gratak/default/obudowa-nodemcu-bme280/img/bottom.png

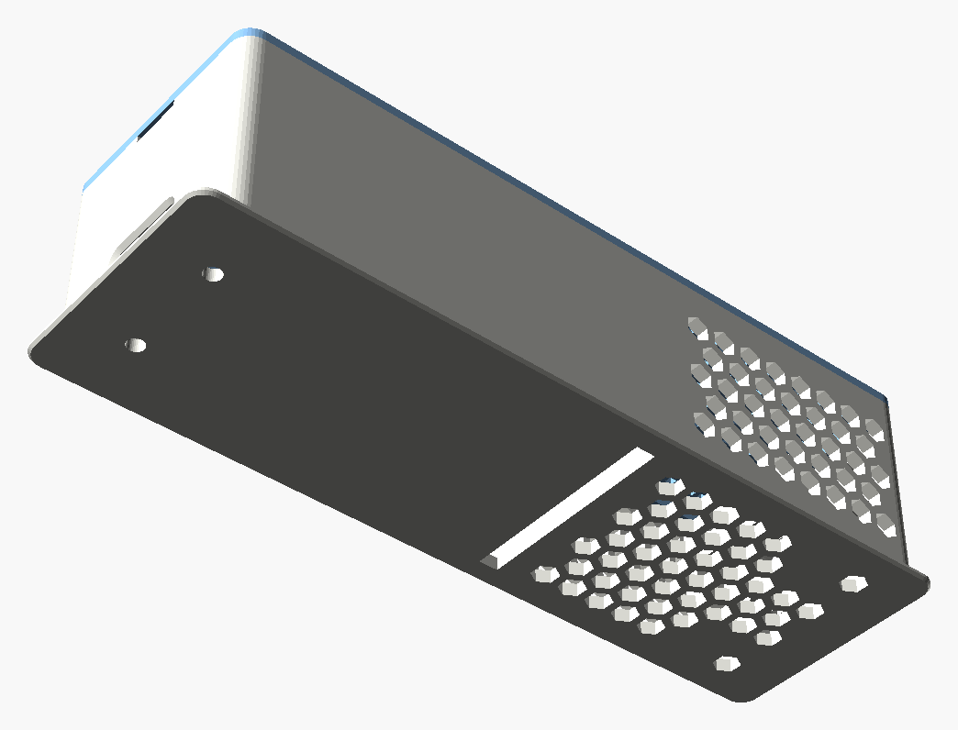
obudowa-nodemcu-bme280/img/bottom.png
