gratak/default/obudowa-nodemcu-bme280/img/cut.png

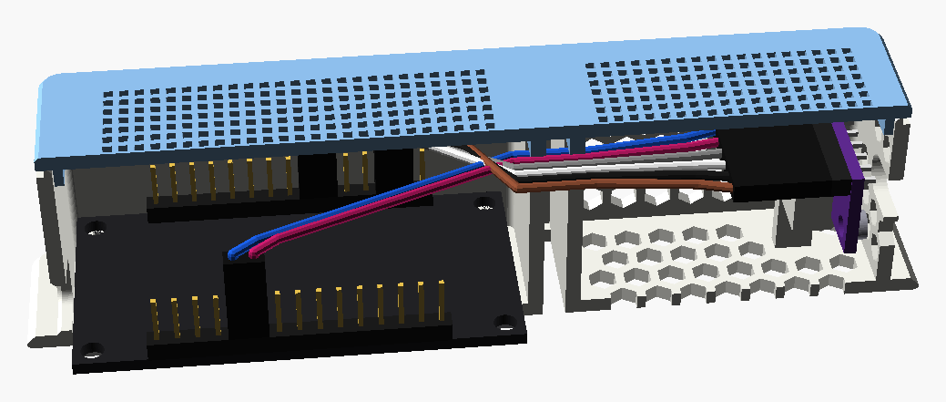
obudowa-nodemcu-bme280/img/cut.png
