gratak/default/obudowa-nodemcu-bme280/img/czujnik.png

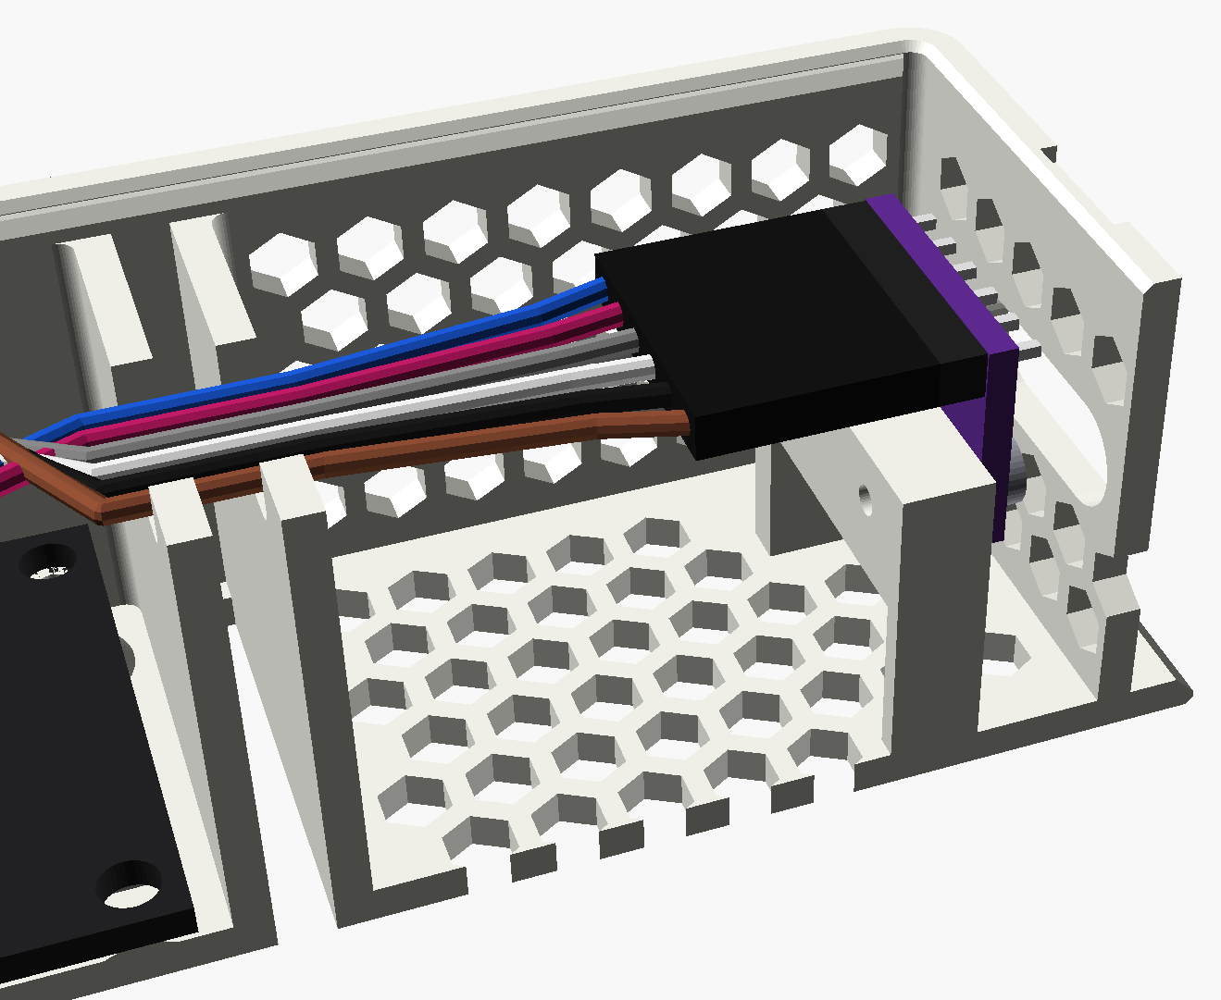
obudowa-nodemcu-bme280/img/czujnik.png
