gratak/default/obudowa-nodemcu-bme280/img/ext1.png

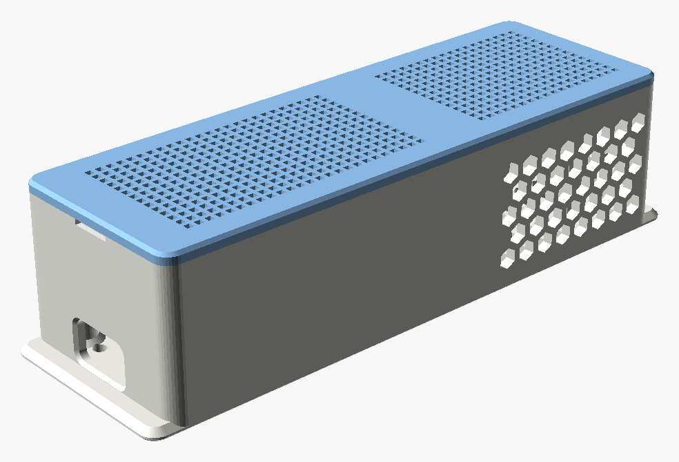
obudowa-nodemcu-bme280/img/ext1.png
