gratak/default/obudowa-nodemcu-bme280/img/ext2.png

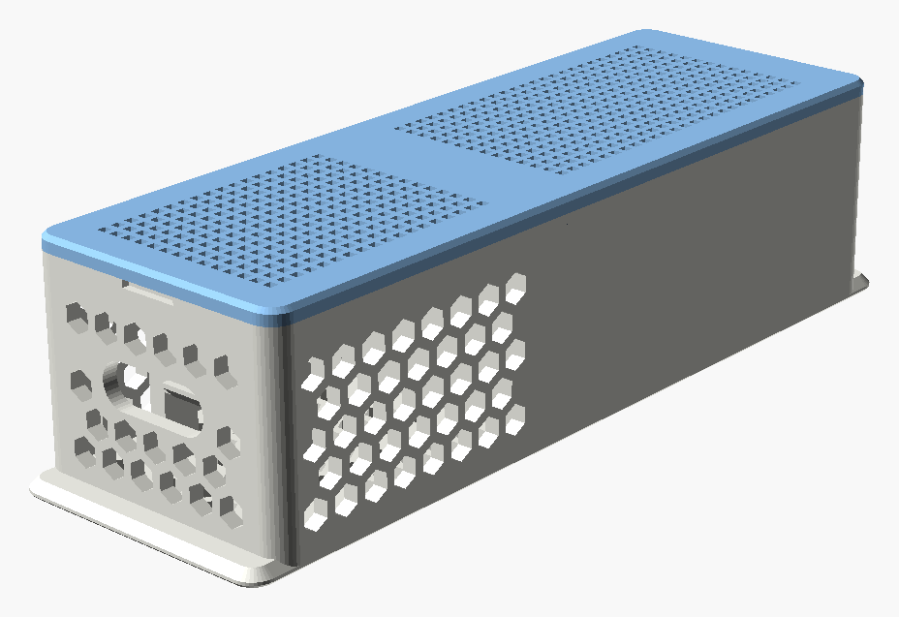
obudowa-nodemcu-bme280/img/ext2.png
