gratak/default/obudowa-nodemcu-bme280/img/kable.png

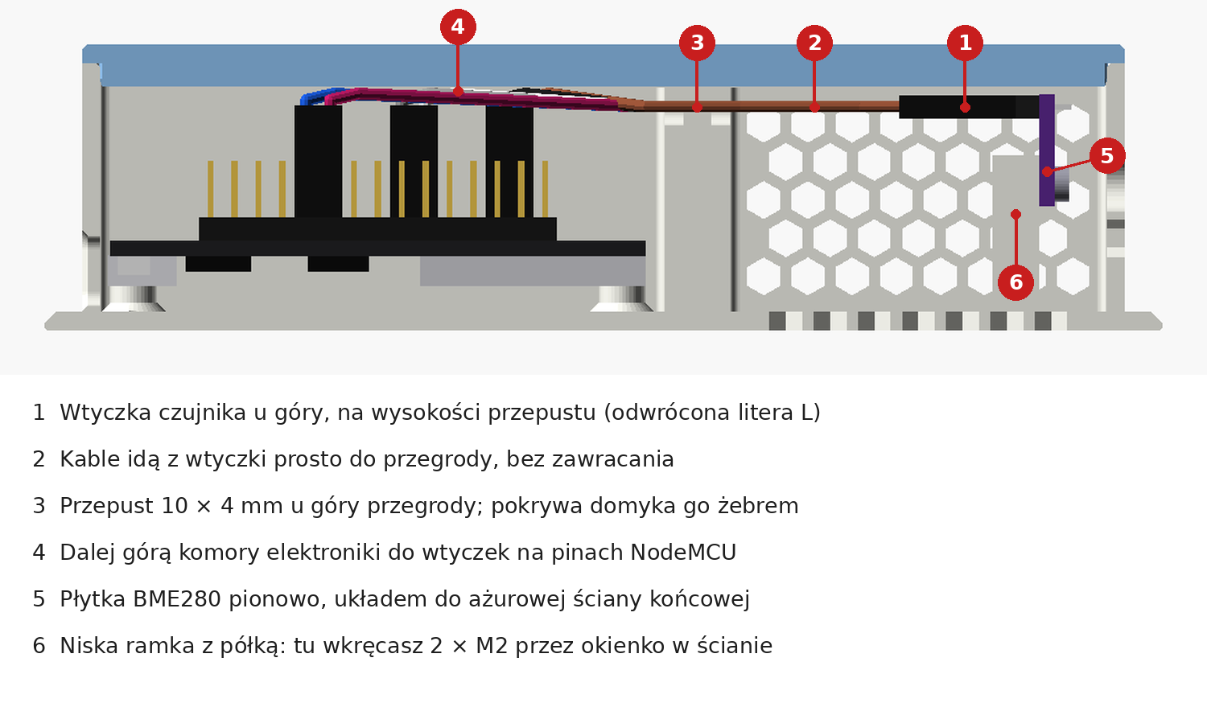
obudowa-nodemcu-bme280/img/kable.png
