gratak/default/obudowa-nodemcu-bme280/img/obudowa_obrot.gif

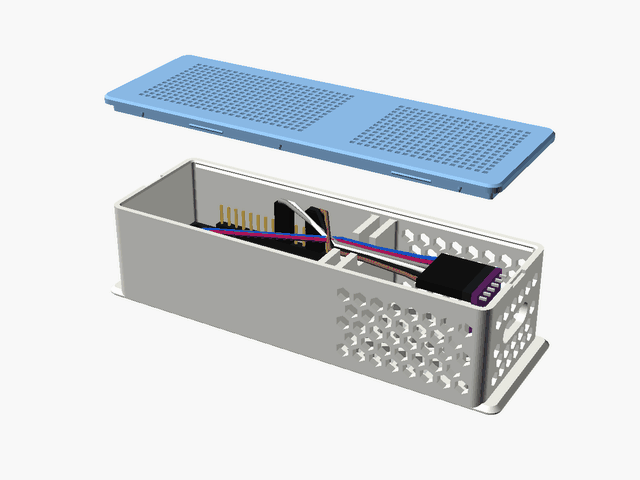
obudowa-nodemcu-bme280/img/obudowa_obrot.gif
