gratak/default/obudowa-nodemcu-bme280/img/okienko.png

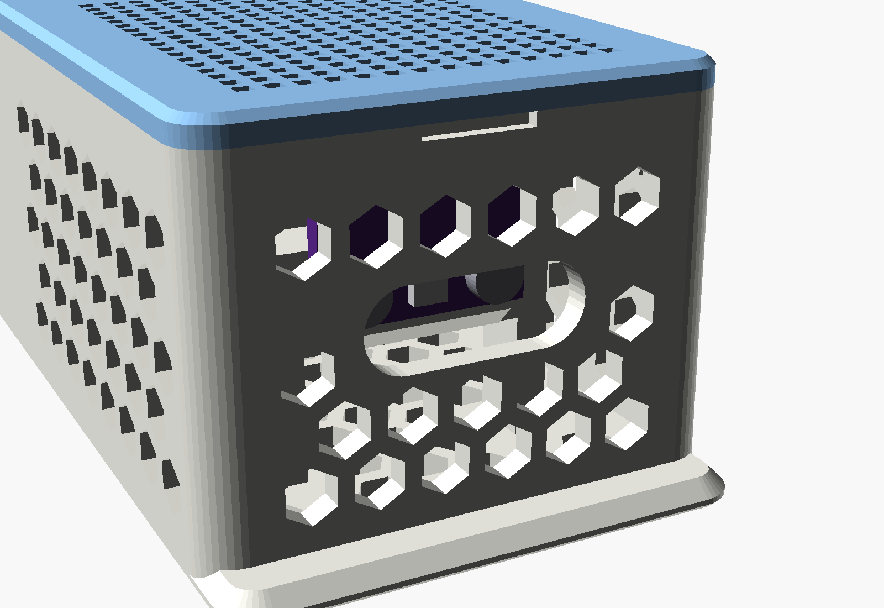
obudowa-nodemcu-bme280/img/okienko.png
