gratak/default/obudowa-nodemcu-bme280/img/open.png

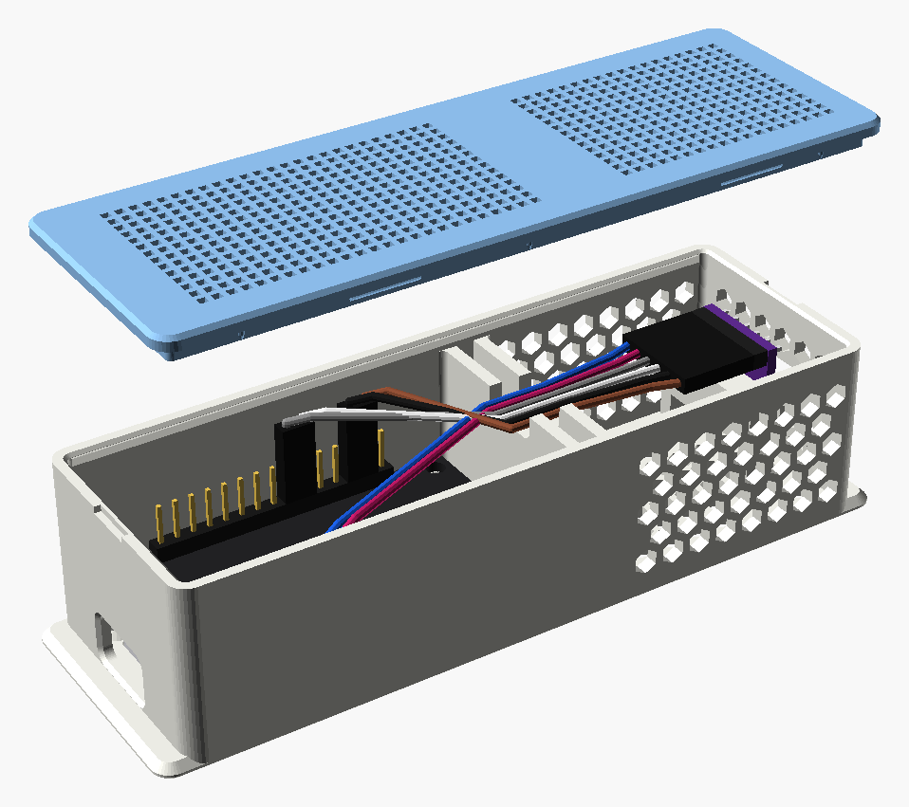
obudowa-nodemcu-bme280/img/open.png
