gratak/default/obudowa-nodemcu-bme280/img/probnik_siatki.png

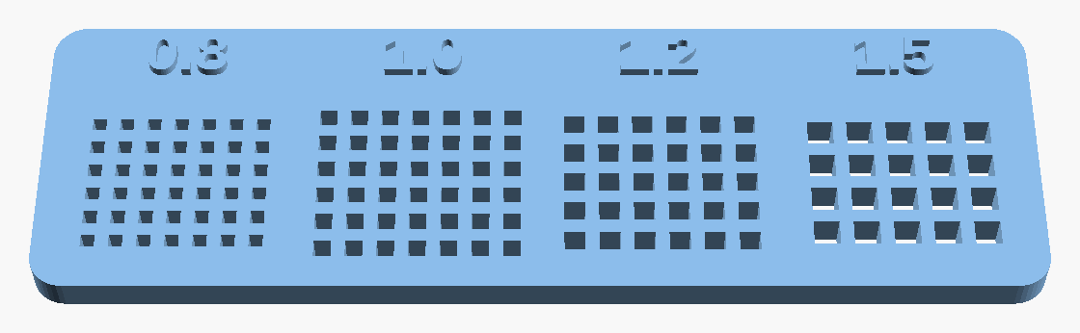
obudowa-nodemcu-bme280/img/probnik_siatki.png
