gratak/default/obudowa-nodemcu-bme280/img/przykrecanie.png

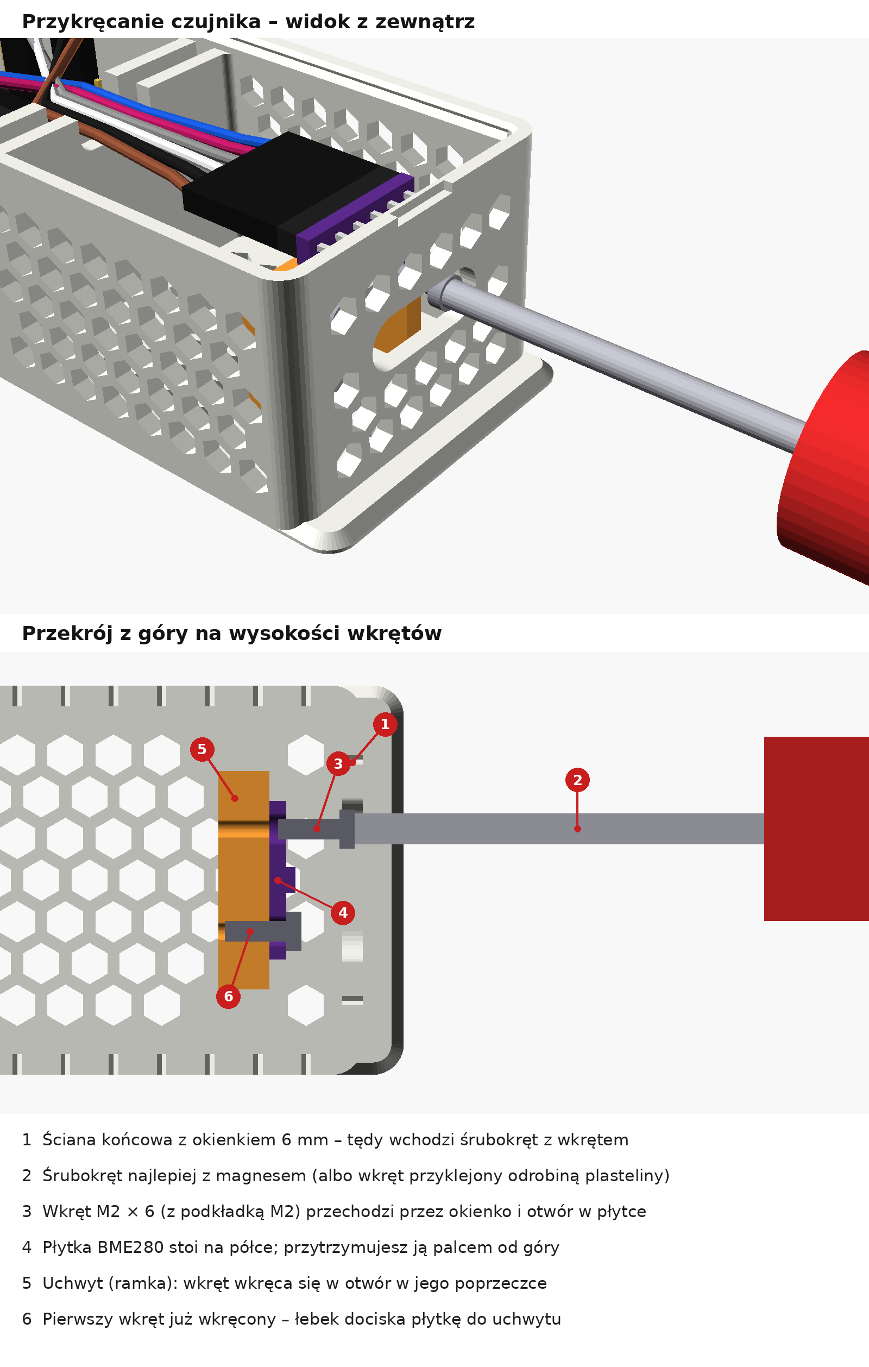
obudowa-nodemcu-bme280/img/przykrecanie.png
