gratak/default/obudowa-nodemcu-bme280/img/uchwyt_done.png

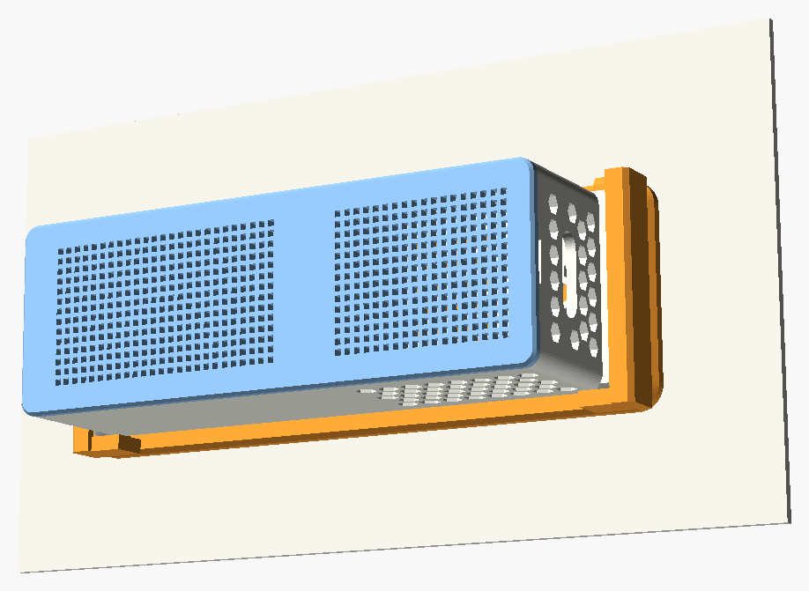
obudowa-nodemcu-bme280/img/uchwyt_done.png
