gratak/default/obudowa-nodemcu-bme280/img/uchwyt_mount.png

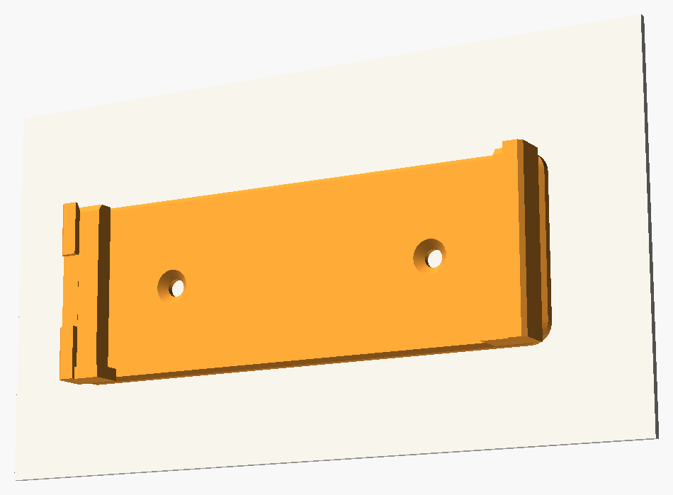
obudowa-nodemcu-bme280/img/uchwyt_mount.png
