gratak/default/obudowa-nodemcu-bme280/img/uchwyt_rail.png

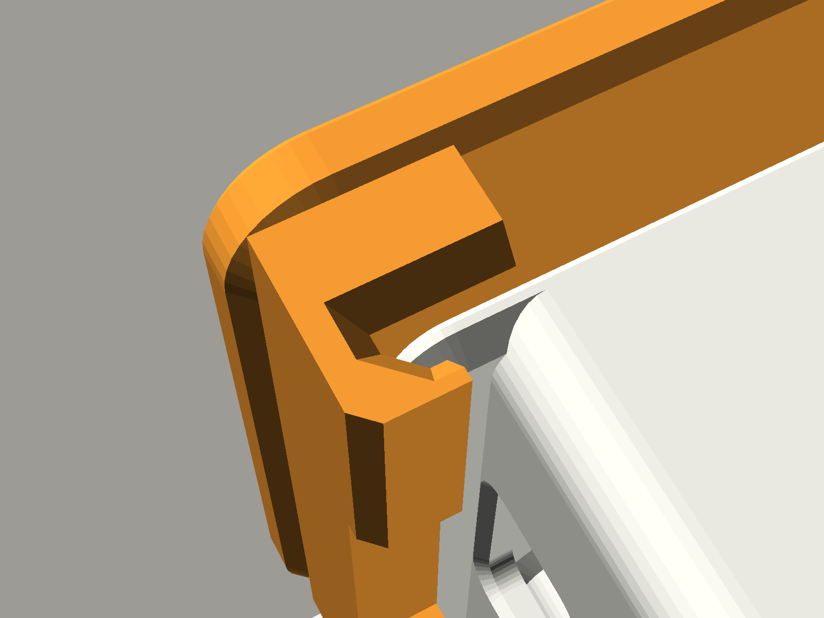
obudowa-nodemcu-bme280/img/uchwyt_rail.png
