gratak/default/obudowa-nodemcu-bme280/img/uchwyt_side.png

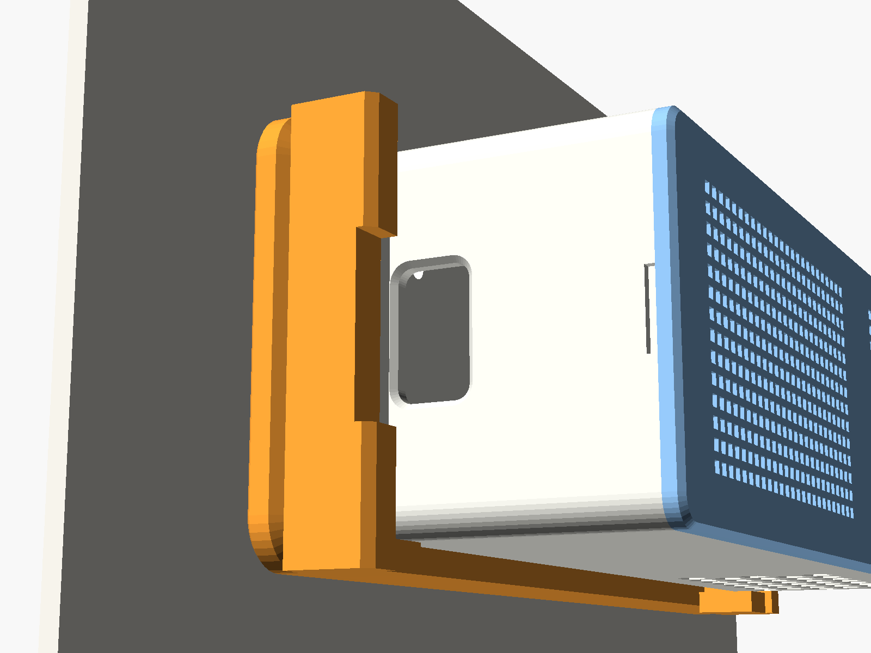
obudowa-nodemcu-bme280/img/uchwyt_side.png
