gratak/default/obudowa-nodemcu-bme280/img/uchwyt_slide.png

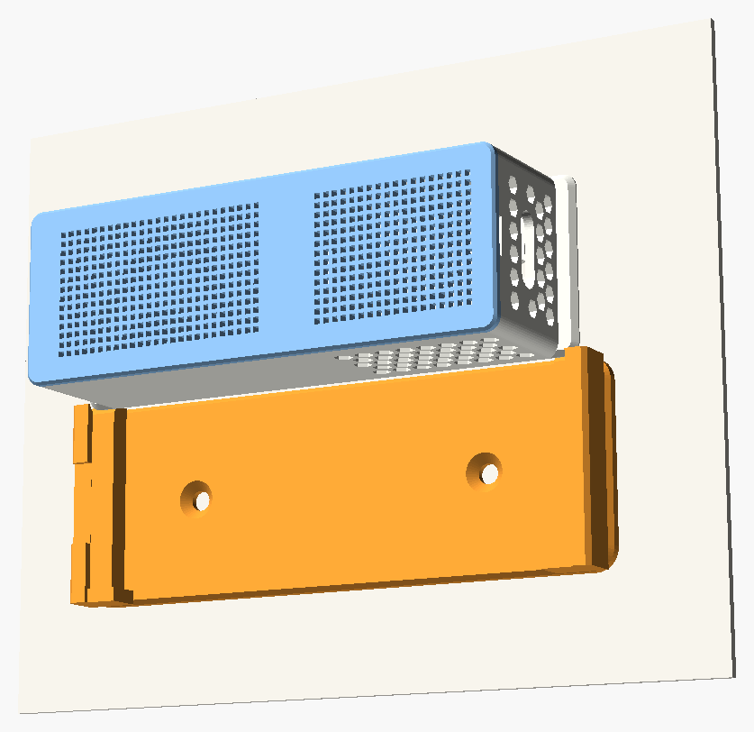
obudowa-nodemcu-bme280/img/uchwyt_slide.png
