gratak/default/obudowa-nodemcu-bme280/img/uchwyt_wsuwanie.gif

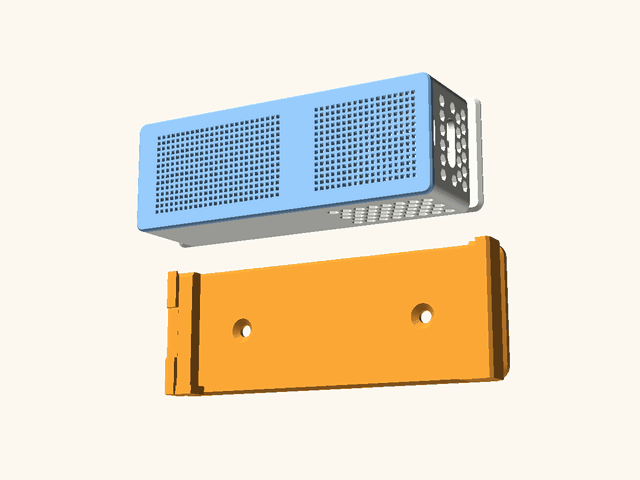
obudowa-nodemcu-bme280/img/uchwyt_wsuwanie.gif
