gratak/default/obudowa-nodemcu-bme280/stl/obudowa_pokrywa.stl

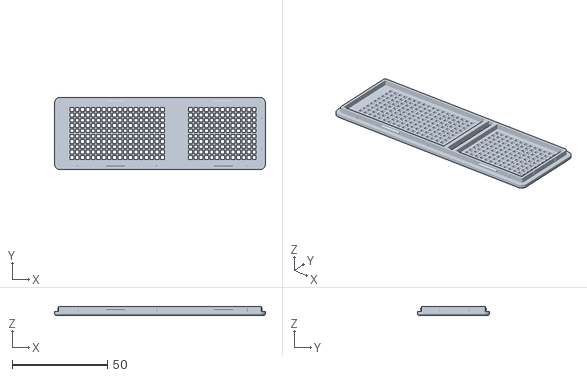
[picture p20: CAD file, 2026-11-12]
obudowa-nodemcu-bme280/stl/obudowa_pokrywa.stl
111.0 x 38.0 x 4.50
