gratak/default/obudowa-nodemcu-bme280/stl/probnik_siatki.stl

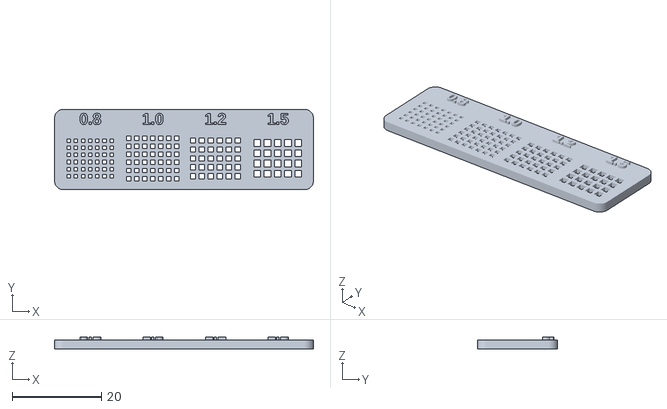
[picture p21: CAD file, 2026-11-10]
obudowa-nodemcu-bme280/stl/probnik_siatki.stl
58.0 x 18.0 x 2.59
