gratak/default/obudowa-nodemcu-bme280/stl/obudowa_podstawa.stl

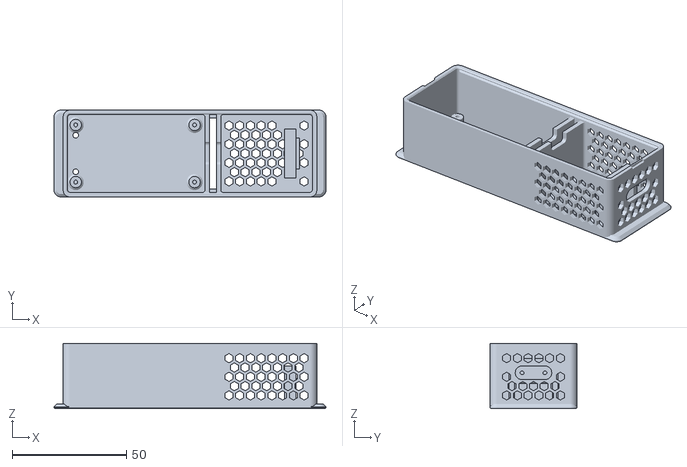
[picture p22: CAD file, 2026-11-10]
obudowa-nodemcu-bme280/stl/obudowa_podstawa.stl
119.0 x 38.0 x 28.6
