gratak/default/obudowa-nodemcu-bme280/stl/obudowa_uchwyt_scienny.stl

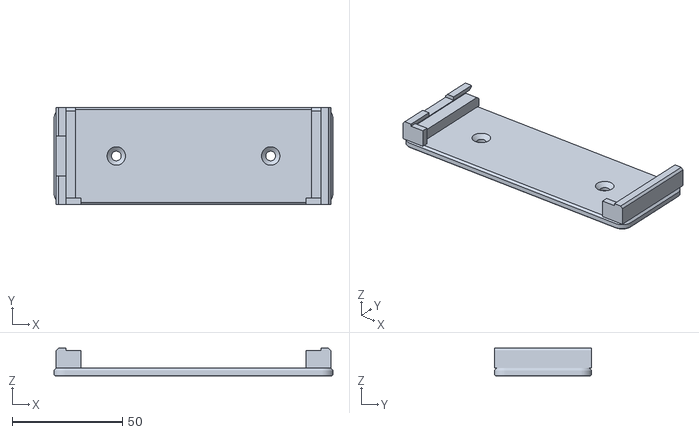
[picture p23: CAD file, 2026-11-10]
obudowa-nodemcu-bme280/stl/obudowa_uchwyt_scienny.stl
126.5 x 44.0 x 12.6
