gratak/default/obudowa-nodemcu-bme280/obudowa.scad

// =====================================================================
//  Obudowa czujnika:  NodeMCU V3 (ESP8266, CH340C, USB-C)  +  GY-BME/P280
// ---------------------------------------------------------------------
//  Plik daje DWIE CZĘŚCI DO DRUKU: podstawę i pokrywę.
//    part = "print" (domyślnie) - obie części ułożone do druku
//    part = "base" / "lid"      - jedna część; F6, potem F7 = plik STL
//    part = "assembly" / "exploded" / "section" - tylko podgląd złożenia;
//           płytki i kable są wtedy półprzezroczystym tłem i nie trafiają do STL
//
//  Dwie komory w jednym pudełku:
//    * ELEKTRONIKA – drobna siatka w pokrywie (krople wody nie przechodzą), USB-C z boku
//    * CZUJNIK     – ażur w ścianach i dnie, drobna siatka w pokrywie
//  Między nimi lita przegroda. Domyślnie PODWÓJNA: dwie pełne ścianki
//  i pionowa szczelina powietrzna, od spodu otwarta, od góry zamknięta pokrywą.
//  therm_gap = 0  ->  zwykła pojedyncza lita ścianka.
//
//  NodeMCU leży jak na zdjęciach: elementami (ESP-12, USB-C) w DÓŁ,
//  pinami i kablami do GÓRY, na 4 dystansach pod otworami 52 x 25 mm.
//
//  CZUJNIK stoi pionowo i razem z wtyczką dupont 1x6 tworzy literę L
//  (odwróconą: piny i wtyczka u góry). Układ BME280 patrzy na ażurową
//  ścianę końcową. Moduł z założoną wtyczką wkłada się od góry przed
//  niską ramkę i stawia na półce; potem 2 wkręty M2 x 6 przez okienko
//  w ścianie końcowej (śrubokręt najlepiej magnetyczny).
//  Komora ma 40 mm: moduł z pinami i zagiętymi kablami (ok. 30 mm) + luz.
//
//  KABLE CZUJNIKA: wtyczka leży na wysokości przepustu u góry przegrody
//  (10 x 4 mm, pokrywa domyka go żebrem), więc kable idą z niej prosto
//  przez przepust i dalej górą komory elektroniki do pinów NodeMCU.
//
//  DRUK bez podpór: podstawa dnem do stołu, pokrywa górą do stołu.
//  PLA/PETG, warstwa 0.2 mm, 3 obrysy, wypełnienie 20 %.
// =====================================================================

/* [Co pokazać] */
// Części do druku albo podgląd złożenia
part = "print"; // [print:Podstawa + pokrywa do druku, mesh_test:Próbnik siatki (test drukarki), print_all:Wszystkie 3 części do druku, base:Podstawa, lid:Pokrywa, mount:Uchwyt ścienny, wall:Podgląd - na ścianie, assembly:Podgląd - złożona, exploded:Podgląd - rozłożona, section:Podgląd - przekrój]
// W podglądzie (F5) pokaż kolorowe modele płytek i kabli; w renderze F6 i w STL ich nie ma
show_pcb = true;

/* [NodeMCU V3] */
pcb_l   = 57;   // długość płytki
pcb_w   = 30;   // szerokość płytki
pcb_t   = 1.6;  // grubość laminatu
hole_dx = 52;   // rozstaw otworów montażowych wzdłuż (środek-środek)
hole_dy = 25;   // rozstaw otworów w poprzek
// Wysokość dystansów = luz pod płytką (od spodu: ESP-12, USB-C, przyciski ~3.3 mm)
under_clear = 6;
// Miejsce nad laminatem: goldpiny + wtyczki dupont + zagięte kable (z zapasem)
above_clear = 19;

/* [USB-C] */
usb_w = 13;    // szerokość otworu (mieści obudowę wtyku kabla)
usb_h = 7.5;   // wysokość otworu
// Środek gniazda względem SPODU laminatu (gniazdo jest od spodu, więc ujemnie)
usb_z = -1.6;
// Przesunięcie gniazda w poprzek względem środka płytki
usb_y = 0;

/* [Mocowanie NodeMCU] */
// screw = wkręty w dystanse; peg = kołki w otworach + dociski w pokrywie
board_fix = "screw"; // [screw:Wkręty, peg:Kołki i docisk pokrywą]
standoff_d = 5;
// Otwór pod wkręt: M2 samogwintujący ~1.7 mm (M2.5 ~2.2 mm, M3 ~2.6 mm)
pilot_d = 1.7;
// Średnica kołka (otwory w płytce mają ok. 3 mm)
peg_d = 2.6;
// Otworki w dnie pod przyciskami RST i FLASH (wciskane spinaczem)
button_holes = true;

/* [Czujnik BME280] */
// Długość wewnętrzna komory czujnika (moduł z pinami i zagiętymi kablami ~30 mm + luz)
sens_len = 40;
// screw = płytka przykręcona do ramki; cradle = bez wkrętów (wtyczka w kołysce, docisk pokrywą)
sensor_mount = "screw"; // [screw:Przykręcany do ramki, cradle:Wtyczka w kołysce + docisk]
sens_w = 15.5;      // szerokość płytki czujnika (wzdłuż rzędu pinów)
sens_t = 1.6;       // grubość płytki czujnika
// Rozstaw otworów montażowych czujnika (środek-środek)
sens_hole_dx = 10;
// Odległość: oś rzędu pinów -> oś otworów montażowych (sprawdź na swojej płytce)
sens_pin_hole = 8.2;
// Odległość: oś otworów -> krawędź płytki bez pinów (tą krawędzią płytka stoi na półce)
sens_hole_e = 2.4;
// Otwór pod wkręt w ramce: M2 samogwintujący ~1.7 mm (M2.5 ~2.2 mm, M3 ~2.6 mm)
sens_pilot_d = 1.7;
// Odstęp strony z układem BME280 od ściany końcowej (łebki wkrętów + luz przy wkładaniu)
sens_gap = 5.5;
// Wysokość okienka na śrubokręt w ścianie końcowej (przechodzi przez nie łebek wkrętu)
win_h = 6;
plug_w = 15.24;     // szerokość wtyczki dupont 1x6 (6 x 2.54)
plug_h = 2.54;      // grubość wtyczki
// --- tylko dla sensor_mount = "cradle" ---
plug_ped = 2;       // wtyczka leży na podeście tej wysokości (czujnik nad dnem)
cradle_len = 10;    // długość kołyski
// Słupek w pokrywie dociskający wtyczkę czujnika
plug_holddown = true;

/* [Ściany i przegroda] */
wall = 2;
floor_t = 2;
lid_t = 2;
corner_r = 3;
gap_usb = 1;       // luz: krawędź płytki - ściana z USB
gap_div = 2;       // luz: krawędź płytki - przegroda
gap_side = 2;      // luz boczny (z każdej strony)
div_t = 2;         // grubość ścianki przegrody
// Szczelina powietrzna między ściankami przegrody (0 = jedna lita ścianka)
therm_gap = 3;
// Otwór nad tą szczeliną w pokrywie (wypada nad przepustem kabli; zamknięty chroni przed kroplami)
gap_lid_open = false;
wire_w = 10;       // przepust na kable w przegrodzie - szerokość
wire_d = 4;        // przepust - głębokość od góry przegrody

/* [Pokrywa i zatrzaski] */
lip_h = 2.5;       // wysokość kołnierza pokrywy
lip_t = 1.2;       // grubość kołnierza
fit = 0.15;        // luz pasowania (zwiększ, jeśli pokrywa wchodzi za ciasno)
snap = 0.6;        // wysokość ząbków zatrzasku (0 = tylko na wcisk)
// Żeberka dociskowe na kołnierzu pokrywy: przy zakładaniu lekko się wgniatają
// i kasują luz (0 = bez; za ciasno -> 0.2, nadal luźno -> 0.4)
crush = 0.3;
snap_len = 10;     // długość ząbka

/* [Wentylacja] */
slot_w = 2;          // szerokość szczelin
slot_pitch = 4.5;    // rozstaw szczelin
floor_slots = false; // szczeliny w dnie pod płytką
// Pionowe szczeliny w ścianach bocznych komory elektroniki
el_side_slots = false;
// Pokrywa nad elektroniką: drobna siatka (krople wody nie przechodzą) albo dawne szczeliny
lid_vent = "mesh"; // [mesh:Drobna siatka, slots:Szczeliny]
// Oczko siatki (kwadrat). Dysza 0.4: pewnie 1.0-1.2 mm, mniejsze potrafią zarosnąć
mesh_hole = 2;
// Mostek między oczkami: 0.8 mm = 2 ścieżki dyszy 0.4
mesh_web = 0.8;
// Ażur w ścianach i dnie komory czujnika (mesh = drobna siatka jak w pokrywie)
hole_shape = "hex"; // [hex:Plaster miodu, circle:Okrągłe oczka, mesh:Drobna siatka]
// Pokrywa nad czujnikiem: drobna siatka (krople wody nie przechodzą) albo ażur jak w ścianach
lid_sensor_mesh = true;
hole_size = 3.5;     // wielkość oczka ażuru (tylko hex / circle)
hole_web = 1.2;      // mostek między oczkami (tylko hex / circle)

/* [Uchwyt ścienny] */
// Kołnierze na końcach podstawy, którymi obudowa wsuwa się w uchwyt ścienny
wall_mount = true;
// Po której stronie jest USB-C, patrząc na zamontowaną obudowę
usb_side = "left"; // [left:Lewa, right:Prawa]
fl_w = 4;            // wysunięcie kołnierza poza ścianę czołową
fl_t = 2;            // grubość kołnierza
fl_base = 0.8;       // pionowa krawędź kołnierza (wyżej skos 45° = jaskółczy ogon)
mnt_gap = 5;         // szczelina powietrzna między płytą uchwytu a dnem obudowy
mnt_plate = 3.5;     // grubość płyty uchwytu
mnt_clear = 0.25;    // luz w prowadnicach (zwiększ, jeśli obudowa wchodzi za ciasno)
mnt_wall = 2.5;      // grubość zewnętrznej ścianki prowadnicy
mnt_lip = 1.8;       // grubość wargi nad kołnierzem
mnt_margin = 3;      // płyta wystaje tyle nad i pod obudowę
screw_wall_d = 4;    // wkręty do ściany (3.5-4 mm, z kołkiem)
screw_wall_head = 8; // średnica łba wkrętu stożkowego
screw_wall_dx = 70;  // rozstaw otworów w płycie

/* [Hidden] */
$fn = 40;
eps = 0.01;

// ---------------------------------------------------------------------
//  Wymiary wynikowe  (oś X: od ściany z USB, Y: od przodu, Z: od dna)
// ---------------------------------------------------------------------
in_w    = pcb_w + 2*gap_side;                  // szerokość wnętrza
el_len  = gap_usb + pcb_l + gap_div;           // długość komory elektroniki
in_h    = under_clear + pcb_t + above_clear;   // wysokość wnętrza
div_tot = therm_gap > 0 ? 2*div_t + therm_gap : div_t;

L  = 2*wall + el_len + div_tot + sens_len;     // długość zewnętrzna
W  = in_w + 2*wall;                            // szerokość zewnętrzna
Hb = floor_t + in_h;                           // wysokość podstawy
H  = Hb + lid_t;                               // wysokość całkowita

x_d1 = wall + el_len;       // przegroda od strony elektroniki
x_s0 = x_d1 + div_tot;      // początek komory czujnika
x_s1 = x_s0 + sens_len;     // koniec komory czujnika
yc   = W/2;

r_in    = max(corner_r - wall, 0.4);
pcb_x0  = wall + gap_usb;
pcb_y0  = wall + gap_side;
pcb_z0  = floor_t + under_clear;   // spód laminatu
div_top = Hb - lip_h - 0.2;        // góra przegrody w podstawie (wyżej są żebra pokrywy)
lip_in  = wall + fit + lip_t;      // wewnętrzna krawędź kołnierza
zg      = Hb - lip_h/2;            // wysokość zatrzasków

holes = [for (i = [0, 1], j = [0, 1])
         [pcb_x0 + (pcb_l - hole_dx)/2 + i*hole_dx,
          pcb_y0 + (pcb_w - hole_dy)/2 + j*hole_dy]];

// --- czujnik (układ L: płytka pionowo, wtyczka poziomo) ---
screw_s  = sensor_mount == "screw";
hl       = 12.5;                              // długość wtyczki dupont (model poglądowy)
sens_d   = 1.3 + sens_pin_hole + sens_hole_e; // wysokość płytki czujnika (model)
s_back   = x_s1 - sens_gap - sens_t;          // tył płytki (strona z wtyczką)
s_face   = s_back + sens_t;                   // strona z układem BME280
plug_end = s_back - 2.5 - hl;                 // koniec wtyczki, z którego wychodzą kable
// screw: piny i wtyczka u góry, na wysokości przepustu w przegrodzie
// cradle: piny i wtyczka na dole, wtyczka w kołysce
pin_z    = screw_s ? div_top - wire_d/2 : floor_t + plug_ped + plug_h/2;
s_hz     = screw_s ? pin_z - sens_pin_hole : pin_z + sens_pin_hole;   // oś otworów
s_hys    = [yc - sens_hole_dx/2, yc + sens_hole_dx/2];
pcb_lo   = screw_s ? s_hz - sens_hole_e : pin_z - 1.3;               // dolna krawędź płytki

// ramka za płytką (tylko screw): nóżki + poprzeczka z otworami + półka pod płytkę
fr_t   = 5;                 // grubość (X)
fr_leg = 2.4;               // grubość nóżki (Y)
fr_in  = sens_w/2 + 0.5;    // wewnętrzna krawędź nóżki od osi
fr_z0  = s_hz - 4.5;        // poprzeczka: dół
fr_z1  = s_hz + 3;          // poprzeczka: góra (wtyczka przechodzi nad nią)

// kołyska (tylko cradle)
holddown  = !screw_s && plug_holddown;
rail_t    = 1.2;
cradle_iw = plug_w + 0.4;
plug_z    = floor_t + plug_ped;               // spód wtyczki
cradle_x0 = plug_end + 0.5;
post_x    = cradle_x0 + cradle_len/2;

echo(str("Obudowa zewn.: ", L, " x ", W, " x ", H, " mm  (dł. x szer. x wys.)"));
if (screw_s)
    echo(str("Czujnik: otwory montażowe ", s_hz, " mm nad spodem, rozstaw ", sens_hole_dx,
             " mm; od końca wtyczki do przegrody ", plug_end - x_s0, " mm"));

// ---------------------------------------------------------------------
//  Pomocnicze kształty 2D
// ---------------------------------------------------------------------
module rrect(s, r) {
    if (r > 0) translate([r, r]) offset(r = r) square([s[0] - 2*r, s[1] - 2*r]);
    else square(s);
}

// szczelina wzdłuż +Y (0..len), wyśrodkowana w X
module stadium(len, w) {
    hull() {
        translate([0, w/2]) circle(d = w);
        translate([0, len - w/2]) circle(d = w);
    }
}

// rząd szczelin pionowych (wzdłuż Y) w prostokącie w x h
// drobna siatka: kwadratowe oczka mesh_hole co (mesh_hole + mesh_web), wyśrodkowana w w x h
module mesh_grid(w, h, hole = mesh_hole, web = mesh_web) {
    p  = hole + web;
    nx = floor((w - hole) / p);
    ny = floor((h - hole) / p);
    ox = (w - nx*p - hole) / 2;
    oy = (h - ny*p - hole) / 2;
    if (nx >= 0 && ny >= 0)
        for (i = [0:nx], j = [0:ny]) translate([ox + i*p, oy + j*p]) square(hole);
}

// próbnik: 4 pola siatki (oczka 0.8 / 1.0 / 1.2 / 1.5 mm) w płytce o grubości pokrywy
module mesh_test() {
    sizes = [0.8, 1.0, 1.2, 1.5];
    difference() {
        linear_extrude(lid_t) rrect([4*14 + 2, 18], 2);
        for (k = [0:3]) translate([2 + k*14, 2, -1]) linear_extrude(lid_t + 2)
            mesh_grid(12, 10, sizes[k], mesh_web);
    }
    // opisy na górze płytki
    for (k = [0:3]) translate([2 + k*14 + 6, 14.6, lid_t - eps]) linear_extrude(0.6)
        text(["0.8", "1.0", "1.2", "1.5"][k], size = 2.6, halign = "center", font = "Liberation Sans:style=Bold");
}

module slot_row(w, h, m = 0) {
    n  = floor((w - 2*m - slot_w) / slot_pitch);
    ox = (w - n*slot_pitch) / 2;
    if (n >= 0) for (i = [0:n]) translate([ox + i*slot_pitch, m]) stadium(h - 2*m, slot_w);
}

// pojedyncze oczko ażuru; heksagon "ostrzem do góry" drukuje się bez podpór
module cell() {
    if (hole_shape == "hex") rotate(30) circle(r = hole_size/sqrt(3), $fn = 6);
    else circle(d = hole_size, $fn = 24);
}

function hit(cx, cy, rx, ry, ex) =
    len([for (e = ex) if (cx + rx > e[0] && cx - rx < e[2] &&
                          cy + ry > e[1] && cy - ry < e[3]) 1]) > 0;
function hitc(cx, cy, rr, ec) =
    len([for (c = ec) if (norm([cx - c[0], cy - c[1]]) < c[2] + rr) 1]) > 0;
// odległość punktu p od odcinka a-b
function seg_dist(p, a, b) =
    let(ab = b - a, t = max(0, min(1, ((p - a)*ab) / (ab*ab)))) norm(p - (a + t*ab));
function hits(cx, cy, rr, es) =
    len([for (s = es) if (seg_dist([cx, cy], [s[0], s[1]], [s[2], s[3]]) < s[4] + rr) 1]) > 0;

// siatka oczek (plaster miodu) mieszcząca się w prostokącie w x h z marginesem m;
// bez otworów w miejscach: ex = prostokąty [x0,y0,x1,y1], ec = koła [x,y,r],
// es = podłużne otwory [x0,y0,x1,y1,r] (odcinek + promień)
module cell_grid(w, h, m = 1.2, ex = [], ec = [], es = []) {
    if (hole_shape == "mesh") mesh_cells(w, h, m, ex, ec, es);
    else hex_cells(w, h, m, ex, ec, es);
}

// drobna siatka z kwadratowych oczek (mesh_hole co mesh_hole + mesh_web) z tymi samymi wykluczeniami
module mesh_cells(w, h, m, ex, ec, es) {
    f  = mesh_hole;
    p  = mesh_hole + mesh_web;
    rr = f/sqrt(2);                 // połowa przekątnej oczka
    nx = floor((w - 2*m - f) / p);
    ny = floor((h - 2*m - f) / p);
    ox = (w - nx*p) / 2;
    oy = (h - ny*p) / 2;
    if (nx >= 0 && ny >= 0)
        for (j = [0:ny], i = [0:nx]) {
            cx = ox + i*p;
            cy = oy + j*p;
            if (!hit(cx, cy, f/2 + mesh_web/2, f/2 + mesh_web/2, ex) &&
                !hitc(cx, cy, rr, ec) && !hits(cx, cy, rr, es))
                translate([cx - f/2, cy - f/2]) square(f);
        }
}

module hex_cells(w, h, m, ex, ec, es) {
    f  = hole_size;
    hh = hole_shape == "hex" ? 2*hole_size/sqrt(3) : hole_size;
    px = f + hole_web;
    py = px*sqrt(3)/2;
    nx = floor((w - 2*m - f) / px);
    ny = floor((h - 2*m - hh) / py);
    ox = (w - nx*px) / 2;
    oy = (h - ny*py) / 2;
    if (nx >= 0 && ny >= 0)
        for (j = [0:ny], i = [0:nx]) {
            cx = ox + i*px + (j % 2)*px/2;
            cy = oy + j*py;
            if (cx + f/2 <= w - m + eps &&
                !hit(cx, cy, f/2 + hole_web/2, hh/2 + hole_web/2, ex) &&
                !hitc(cx, cy, hh/2, ec) && !hits(cx, cy, hh/2, es))
                translate([cx, cy]) cell();
        }
}

// ---------------------------------------------------------------------
//  Przenoszenie wzorów 2D na ściany (narzędzia do wycinania)
// ---------------------------------------------------------------------
// ściana przednia i tylna: 2D (u,v) -> (x0+u, z0+v)
module through_long_walls(x0, z0) {
    for (y = [wall + 1, W + 1])
        translate([x0, y, z0]) rotate([90, 0, 0]) linear_extrude(wall + 2) children();
}
// ściana czołowa (x = 0 lub x = L): 2D (u,v) -> (y0+u, z0+v)
module through_end_wall(xw, y0, z0) {
    translate([xw - 1, y0, z0]) rotate([90, 0, 90]) linear_extrude(wall + 2) children();
}

// trójkątny ząbek wzdłuż X (0..len), wystaje w -Y, symetryczny względem z = 0
module ridge(len, h) {
    rotate([0, 90, 0]) linear_extrude(len) polygon([[h, 0], [-h, 0], [0, -h]]);
}
// to samo po stronie tylnej (lustro względem środka szerokości)
module both_sides() {
    children();
    translate([0, W, 0]) mirror([0, 1, 0]) children();
}

// okienko w ścianie końcowej na śrubokręt (przed układem BME280)
module sensor_window_2d() {
    hull() for (y = s_hys) translate([y, s_hz]) circle(d = win_h);
}

// ---------------------------------------------------------------------
//  PODSTAWA
// ---------------------------------------------------------------------
module base() {
    difference() {
        union() {
            difference() {
                // bryła z fazką 0.4 mm przy stole (kompensacja "stopy słonia")
                union() {
                    hull() {
                        translate([0.4, 0.4, 0]) linear_extrude(eps) rrect([L - 0.8, W - 0.8], corner_r - 0.4);
                        translate([0, 0, 0.4]) linear_extrude(Hb - 0.4) rrect([L, W], corner_r);
                    }
                    if (wall_mount) flange();
                }
                // komora elektroniki
                translate([wall, wall, floor_t]) linear_extrude(Hb) rrect([el_len, in_w], r_in);
                // komora czujnika
                translate([x_s0, wall, floor_t]) linear_extrude(Hb) rrect([sens_len, in_w], r_in);
                // szczelina termiczna między ściankami przegrody
                if (therm_gap > 0)
                    translate([x_d1 + div_t, wall, floor_t]) cube([therm_gap, in_w, Hb]);
                // nad przegrodą wspólna wnęka na kołnierz pokrywy
                translate([wall, wall, div_top]) linear_extrude(Hb) rrect([L - 2*wall, in_w], r_in);
            }
            // dystanse pod NodeMCU
            for (h = holes) translate([h[0], h[1], floor_t - eps]) {
                cylinder(d1 = standoff_d + 2, d2 = standoff_d, h = 1);
                cylinder(d = standoff_d, h = under_clear + eps);
                if (board_fix == "peg") translate([0, 0, under_clear]) {
                    cylinder(d = peg_d, h = pcb_t + 0.7);
                    translate([0, 0, pcb_t + 0.7 - eps])
                        cylinder(d1 = peg_d, d2 = peg_d - 0.8, h = 0.5);
                }
            }
            if (screw_s) {
                // niska ramka za płytką czujnika: dwie nóżki + poprzeczka z otworami;
                // wtyczka czujnika jest wyżej, więc moduł wkłada się od góry
                for (s = [-1, 1])
                    translate([s_back - fr_t, s > 0 ? yc + fr_in : yc - fr_in - fr_leg, floor_t - eps])
                        cube([fr_t, fr_leg, fr_z1 - floor_t + eps]);
                translate([s_back - fr_t, yc - fr_in - fr_leg, fr_z0])
                    cube([fr_t, 2*(fr_in + fr_leg), fr_z1 - fr_z0]);
                // półka pod dolną krawędzią płytki (ustawia wysokość przy wkręcaniu), spód 45°
                translate([s_back - eps, yc + sens_w/2 - 1, pcb_lo]) rotate([90, 0, 0])
                    linear_extrude(sens_w - 2)
                        polygon([[0, 0], [sens_t, 0], [sens_t, -0.6], [0, -0.6 - sens_t]]);
            } else {
                // kołyska wtyczki czujnika: podest + dwie prowadnice
                translate([cradle_x0, yc - cradle_iw/2 - rail_t, 0])
                    cube([cradle_len, cradle_iw + 2*rail_t, plug_z]);
                for (s = [-1, 1])
                    translate([cradle_x0, yc + s*(cradle_iw + rail_t)/2 - rail_t/2, 0])
                        cube([cradle_len, rail_t, plug_z + plug_h + 0.6]);
            }
        }

        // otwory pod wkręty NodeMCU
        if (board_fix == "screw")
            for (h = holes) translate([h[0], h[1], 0.8]) cylinder(d = pilot_d, h = Hb);
        // otwory pod wkręty czujnika (poziomo, w poprzeczce ramki)
        if (screw_s)
            for (y = s_hys) translate([s_back - fr_t - 1, y, s_hz]) rotate([0, 90, 0])
                cylinder(d = sens_pilot_d, h = fr_t + 2);

        // USB-C (z fazką od zewnątrz)
        usb_cut();

        // przepust na kable w przegrodzie (zamykany od góry żebrem pokrywy)
        translate([x_d1 - 1, yc - wire_w/2, div_top - wire_d])
            rotate([90, 0, 90]) linear_extrude(div_tot + 2) rrect([wire_w, wire_d + 3], 1.5);

        // szczelina termiczna otwarta w dnie (komin)
        if (therm_gap > 0)
            translate([x_d1 + div_t, wall + 1.5, -1]) cube([therm_gap, in_w - 3, floor_t + 2]);

        // ELEKTRONIKA: pionowe szczeliny w ścianie przedniej i tylnej
        if (el_side_slots) through_long_walls(wall + 3, floor_t + 1.5)
            slot_row(x_d1 - 2 - (wall + 3), div_top - 1.5 - (floor_t + 1.5));

        // ELEKTRONIKA: podłużne szczeliny w dnie pod płytką
        if (floor_slots)
            for (k = [-2:2])
                translate([pcb_x0 + 9, yc + k*slot_pitch, -1])
                    rotate(-90) linear_extrude(floor_t + 2) stadium(pcb_l - 17, slot_w);

        // otworki pod RST / FLASH
        if (button_holes)
            for (yb = [7, pcb_w - 7])
                translate([pcb_x0 + 2.5, pcb_y0 + yb, -1]) cylinder(d = 2.5, h = floor_t + 2);

        // CZUJNIK: ażur w ścianach bocznych
        through_long_walls(x_s0, floor_t) cell_grid(sens_len, div_top - floor_t);
        // ... w ścianie końcowej (+ okienko na śrubokręt przed układem)
        through_end_wall(L - wall, wall, floor_t)
            cell_grid(in_w, div_top - floor_t, 1.2, [], [],
                      screw_s ? [[s_hys[0] - wall, s_hz - floor_t, s_hys[1] - wall, s_hz - floor_t,
                                  win_h/2 + 0.75]] : []);
        if (screw_s) through_end_wall(L - wall, 0, 0) sensor_window_2d();
        // ... i w dnie (bez oczek pod nóżkami ramki / pod kołyską)
        translate([x_s0, wall, -1]) linear_extrude(floor_t + 2)
            if (screw_s)
                cell_grid(sens_len, in_w, 1.2,
                          [for (s = [-1, 1]) let(y0 = s > 0 ? yc + fr_in : yc - fr_in - fr_leg)
                              [s_back - fr_t - x_s0 - 0.3, y0 - wall - 0.3,
                               s_back - x_s0 + 0.3, y0 + fr_leg - wall + 0.3]]);
            else
                cell_grid(sens_len, in_w, 1.2,
                          [[cradle_x0 - x_s0 - 0.5, in_w/2 - cradle_iw/2 - rail_t - 0.5,
                            cradle_x0 - x_s0 + cradle_len + 0.5, in_w/2 + cradle_iw/2 + rail_t + 0.5]]);

        // rowek zatrzasku wzdłuż ścian bocznych
        if (snap > 0)
            both_sides() translate([wall, wall, zg]) ridge(L - 2*wall, snap + 0.1);

        // fazka wejścia pokrywy
        translate([0, 0, Hb - 0.5]) hull() {
            translate([wall, wall, 0]) linear_extrude(eps) rrect([L - 2*wall, in_w], r_in);
            translate([wall - 0.5, wall - 0.5, 0.5]) linear_extrude(0.1)
                rrect([L - 2*wall + 1, in_w + 1], r_in + 0.5);
        }

        // wcięcia do podważenia pokrywy (oba końce)
        for (xx = [-1, L - wall/2])
            translate([xx, yc - 4, Hb - 1]) cube([wall/2 + 1, 8, 2]);
    }
}

module usb_cut() {
    zc = pcb_z0 + usb_z;
    y0 = pcb_y0 + pcb_w/2 + usb_y - usb_w/2;
    through_end_wall(0, y0, zc - usb_h/2) rrect([usb_w, usb_h], 1.5);
    hull() {
        translate([-eps, y0 - 0.6, zc - usb_h/2 - 0.6]) rotate([90, 0, 90])
            linear_extrude(eps) rrect([usb_w + 1.2, usb_h + 1.2], 2.1);
        translate([0.6, y0, zc - usb_h/2]) rotate([90, 0, 90])
            linear_extrude(eps) rrect([usb_w, usb_h], 1.5);
    }
}

// ---------------------------------------------------------------------
//  POKRYWA (w położeniu złożonym)
// ---------------------------------------------------------------------
module lid() {
    rib_xs = therm_gap > 0 ? [x_d1, x_s0 - div_t] : [x_d1];
    pin_holddown = board_fix == "peg";
    // zakres szczelin nad elektroniką (omija dociski, jeśli są)
    ex0 = pin_holddown ? holes[0][0] + 4 : wall + 6;
    ex1 = pin_holddown ? holes[3][0] - 4 : x_d1 - 4;

    difference() {
        union() {
            // płyta z fazką 0.6 mm na górnej krawędzi
            hull() {
                translate([0, 0, Hb]) linear_extrude(lid_t - 0.6) rrect([L, W], corner_r);
                translate([0.6, 0.6, Hb]) linear_extrude(lid_t) rrect([L - 1.2, W - 1.2], corner_r - 0.6);
            }
            // kołnierz wchodzący w podstawę
            translate([0, 0, Hb - lip_h]) linear_extrude(lip_h + eps) difference() {
                translate([wall + fit, wall + fit])
                    rrect([L - 2*(wall + fit), W - 2*(wall + fit)], max(r_in - fit, 0.3));
                translate([lip_in, lip_in]) square([L - 2*lip_in, W - 2*lip_in]);
            }
            // żebra domykające przegrodę i przepust kabli
            for (x = rib_xs)
                translate([x, wall + fit, Hb - lip_h]) cube([div_t, in_w - 2*fit, lip_h + eps]);
            // żeberka dociskowe: 3 na każdym długim boku, 2 na każdym końcu
            if (crush > 0) {
                for (x = [12, (x_d1 + x_s0)/2 - 12, x_s1 - 8]) both_sides() translate([x, wall + fit, 0]) crush_rib();
                for (y = [yc - 8, yc + 8]) {
                    translate([wall + fit, y, 0]) rotate(90) mirror([0, 1, 0]) crush_rib();
                    translate([L - wall - fit, y, 0]) rotate(90) crush_rib();
                }
            }
            // ząbki zatrzasków: środek komory elektroniki i komory czujnika
            if (snap > 0)
                for (xc = [(wall + x_d1)/2, (x_s0 + x_s1)/2])
                    both_sides() translate([xc - snap_len/2, wall + fit, zg]) ridge(snap_len, snap);
            // słupek dociskający wtyczkę czujnika (tylko wersja z kołyską)
            if (holddown)
                translate([post_x, yc, plug_z + plug_h + 0.3])
                    cylinder(d = 4, h = Hb - (plug_z + plug_h + 0.3) + eps);
            // dociski płytki (tylko przy mocowaniu na kołki)
            if (pin_holddown)
                for (h = holes) translate([h[0], h[1], pcb_z0 + pcb_t + 0.3]) difference() {
                    cylinder(d = 5, h = Hb - (pcb_z0 + pcb_t + 0.3) + eps);
                    translate([0, 0, -1]) cylinder(d = peg_d + 0.8, h = 2.5);
                }
        }
        // nad elektroniką: drobna siatka albo szczeliny poprzeczne
        translate([ex0, lip_in + 1.5, Hb - 1]) linear_extrude(lid_t + 2)
            if (lid_vent == "mesh") mesh_grid(ex1 - ex0, W - 2*lip_in - 3);
            else slot_row(ex1 - ex0, W - 2*lip_in - 3);
        // szczelina termiczna otwarta w pokrywie (domyślnie zamknięta)
        if (therm_gap > 0 && gap_lid_open)
            translate([x_d1 + div_t, lip_in + 1, Hb - 1]) cube([therm_gap, W - 2*lip_in - 2, lid_t + 2]);
        // nad czujnikiem: drobna siatka (domyślnie) albo ażur jak w ścianach
        translate([x_s0, lip_in, Hb - 1]) linear_extrude(lid_t + 2)
            if (lid_sensor_mesh)
                mesh_cells(x_s1 - fit - lip_t - x_s0, W - 2*lip_in, 1.2, [],
                           holddown ? [[post_x - x_s0, yc - lip_in, 2 + 0.8]] : [], []);
            else
                cell_grid(x_s1 - fit - lip_t - x_s0, W - 2*lip_in, 1.2, [],
                          holddown ? [[post_x - x_s0, yc - lip_in, 2 + 0.8]] : []);
    }
}

// pionowe żeberko na zewnętrznej ścianie kołnierza (wystaje o crush w -Y),
// na dole ścięte, żeby pokrywa łatwo trafiała
module crush_rib() {
    translate([0, 0.5 - crush, 0]) {
        translate([0, 0, Hb - lip_h + 0.8]) cylinder(r = 0.5, h = lip_h - 0.8 + eps, $fn = 16);
        translate([0, 0, Hb - lip_h]) cylinder(r1 = 0.5 - crush, r2 = 0.5, h = 0.8 + eps, $fn = 16);
    }
}
// pokrywa obrócona do druku (góra na stole)
module lid_print() {
    translate([0, W, Hb + lid_t]) rotate([180, 0, 0]) lid();
}

// ---------------------------------------------------------------------
//  UCHWYT ŚCIENNY
//  Obudowa wisi poziomo, pokrywą do pokoju, dnem do ściany. Kołnierze na
//  końcach podstawy (skos 45°) wsuwają się od góry w dwie prowadnice
//  (jaskółczy ogon), na dole są ograniczniki. Między dnem a płytą zostaje
//  szczelina powietrzna, więc otwory w dnie dalej działają.
//  Współrzędne jak w podstawie: Y = kierunek wsuwania (w górę na ścianie).
// ---------------------------------------------------------------------
fl_s  = fl_t - fl_base;                       // poziomy zasięg skosu kołnierza
m_xo  = -(fl_w + mnt_clear + mnt_wall);       // zewnętrzna krawędź prowadnicy
m_xl  = -fl_w + fl_s + 0.6;                   // wewnętrzna krawędź wargi
m_zt  = fl_t + mnt_clear + mnt_lip;           // góra prowadnicy
m_y0  = -mnt_margin;                          // dół uchwytu (ogranicznik)
m_y1  = W + mnt_margin;                       // góra uchwytu (wejście)
usb_yc = pcb_y0 + pcb_w/2 + usb_y;

// kołnierz podstawy: wystaje fl_w za ściany czołowe, krawędź ze skosem 45°
module flange() {
    hull() {
        translate([-fl_w + 0.4, 0.4, 0]) linear_extrude(eps)
            rrect([L + 2*fl_w - 0.8, W - 0.8], corner_r - 0.4);
        translate([-fl_w, 0, 0.4]) linear_extrude(fl_base - 0.4) rrect([L + 2*fl_w, W], corner_r);
        translate([-fl_w + fl_s, fl_s, fl_t - eps]) linear_extrude(eps)
            rrect([L + 2*fl_w - 2*fl_s, W - 2*fl_s], corner_r - fl_s);
    }
}

// przekrój kanału prowadnicy (płaszczyzna X-Z, koniec obudowy przy x = 0)
module channel2d() {
    intersection() {
        offset(delta = mnt_clear)
            polygon([[-fl_w, -1], [-fl_w, fl_base], [-fl_w + fl_s, fl_t], [3, fl_t], [3, -1]]);
        translate([-50, 0]) square([100, 50]);
    }
}
// przekrój prowadnicy: podstawa pod dnem obudowy + ścianka + warga nad kołnierzem
module rail2d() {
    difference() {
        union() {
            translate([m_xo, -mnt_gap - eps]) square([2 - m_xo, mnt_gap + eps]);
            polygon([[m_xo, -eps], [m_xl, -eps], [m_xl, m_zt], [m_xo + 1, m_zt], [m_xo, m_zt - 1]]);
        }
        channel2d();
    }
}
// jedna prowadnica z ogranicznikiem; usb = wycięcie w wardze na wtyk USB-C
module rail_end(usb = false, usb_at = 0) {
    difference() {
        union() {
            translate([0, m_y1, 0]) rotate([90, 0, 0]) linear_extrude(m_y1 - m_y0) rail2d();
            // ogranicznik na dole - obudowa na nim stoi
            translate([m_xo, m_y0, -mnt_gap - eps]) cube([4.5 - m_xo, -m_y0, 3 + mnt_gap + eps]);
        }
        // rozszerzone wejście prowadnicy u góry
        hull() {
            translate([0, m_y1 + eps, 0]) rotate([90, 0, 0]) linear_extrude(eps) offset(delta = 1.2) channel2d();
            translate([0, m_y1 - 1.6, 0]) rotate([90, 0, 0]) linear_extrude(eps) channel2d();
        }
        if (usb) translate([m_xo - 1, usb_at - 9, fl_t + 0.3]) cube([1 - m_xo, 18, 20]);
    }
}
module mount_plate() {
    pl = L - 2*m_xo + 2;
    pw = m_y1 - m_y0;
    translate([m_xo - 1, m_y0, -mnt_gap - mnt_plate]) hull() {
        translate([0.4, 0.4, 0]) linear_extrude(eps) rrect([pl - 0.8, pw - 0.8], 4.6);
        translate([0, 0, 0.4]) linear_extrude(mnt_plate - 1.4) rrect([pl, pw], 5);
        translate([1, 1, mnt_plate - eps]) linear_extrude(eps) rrect([pl - 2, pw - 2], 4);
    }
}
module mount() {
    csk = (screw_wall_head - screw_wall_d)/2;
    difference() {
        union() {
            mount_plate();
            rail_end(usb_side == "left", usb_yc);
            translate([L, 0, 0]) mirror([1, 0, 0]) rail_end(usb_side == "right", W - usb_yc);
        }
        // otwory na wkręty do ściany, stożkowe (łeb chowa się w płycie)
        for (s = [-1, 1]) translate([L/2 + s*screw_wall_dx/2, W/2, 0]) {
            translate([0, 0, -mnt_gap - mnt_plate - 1]) cylinder(d = screw_wall_d + 0.4, h = mnt_plate + 2);
            translate([0, 0, -mnt_gap - csk - eps])
                cylinder(d1 = screw_wall_d + 0.4, d2 = screw_wall_head + 0.4, h = csk + 2*eps);
        }
    }
}
// uchwyt ułożony do druku (płytą na stole)
module mount_print() {
    translate([1 - m_xo, -m_y0, mnt_gap + mnt_plate]) mount();
}
// obudowa ustawiona w uchwycie (USB po prawej = obrót o 180° w płaszczyźnie ściany)
module in_mount(slide = 0) {
    translate([0, slide, 0])
        if (usb_side == "right") translate([L, W, 0]) rotate([0, 0, 180]) children();
        else children();
}

// ---------------------------------------------------------------------
//  Modele poglądowe płytek i kabli (tylko podgląd, nie drukować)
// ---------------------------------------------------------------------
pin_x0 = (pcb_l - 14*2.54) / 2;
row_y  = [(pcb_w - 27.94)/2, pcb_w - (pcb_w - 27.94)/2];
// piny z wtyczkami (współrzędne płytki: x od krawędzi z USB)
dup = [[pin_x0 + 13*2.54, row_y[1]], [pin_x0 + 12*2.54, row_y[1]],
       [pin_x0 + 9*2.54,  row_y[1]], [pin_x0 + 8*2.54,  row_y[1]],
       [pin_x0 + 5*2.54,  row_y[0]], [pin_x0 + 4*2.54,  row_y[0]]];
dup_top = pcb_z0 + pcb_t + 2.5 + 12;

module nodemcu_ghost() {
    translate([pcb_x0, pcb_y0, pcb_z0]) {
        color([0.13, 0.13, 0.14]) difference() {
            cube([pcb_l, pcb_w, pcb_t]);
            for (i = [0, 1], j = [0, 1])
                translate([(pcb_l - hole_dx)/2 + i*hole_dx, (pcb_w - hole_dy)/2 + j*hole_dy, -1])
                    cylinder(d = 3, h = pcb_t + 2);
        }
        // od spodu: ESP-12 przy końcu dalszym od USB
        color([0.78, 0.78, 0.8]) translate([pcb_l - 24, (pcb_w - 16)/2, -3.2]) cube([24, 16, 3.2]);
        // gniazdo USB-C
        color([0.85, 0.85, 0.87]) translate([-0.2, pcb_w/2 + usb_y - 4.47, usb_z - 1.63])
            cube([7.35, 8.94, 3.26]);
        // RST / FLASH
        for (yb = [7, pcb_w - 7]) color([0.9, 0.9, 0.9]) translate([0.8, yb - 1.4, -2]) cube([3.5, 2.8, 2]);
        // CH340C, AMS1117
        color([0.05, 0.05, 0.05]) translate([8, pcb_w/2 - 3, -1.7]) cube([7, 6, 1.7]);
        color([0.05, 0.05, 0.05]) translate([21, pcb_w/2 - 3.5, -1.7]) cube([6.5, 7, 1.7]);
        // goldpiny od góry
        for (y = row_y, i = [0:14]) translate([pin_x0 + i*2.54, y, pcb_t]) {
            color([0.1, 0.1, 0.1]) translate([-1.27, -1.27, 0]) cube([2.54, 2.54, 2.5]);
            color([0.9, 0.75, 0.3]) translate([-0.32, -0.32, 0]) cube([0.64, 0.64, 8.5]);
        }
        // wtyczki dupont
        for (p = dup) color([0.07, 0.07, 0.07]) translate([p[0] - 1.27, p[1] - 1.27, pcb_t + 2.5])
            cube([2.54, 2.54, 12]);
    }
}

// czujnik w układzie L: płytka pionowo, listwa + wtyczka poziomo w stronę przegrody
module bme_ghost() {
    color([0.36, 0.16, 0.55]) difference() {
        translate([s_back, yc - sens_w/2, pcb_lo]) cube([sens_t, sens_w, sens_d]);
        for (y = s_hys) translate([s_back - 1, y, s_hz]) rotate([0, 90, 0]) cylinder(d = 3, h = sens_t + 2);
    }
    // układ BME280 między otworami, od strony ściany końcowej
    color([0.82, 0.82, 0.84]) translate([s_face, yc - 1.25, s_hz - 1.25]) cube([0.93, 2.5, 2.5]);
    // końcówki pinów
    for (i = [0:5]) color([0.85, 0.85, 0.85])
        translate([s_face, yc - 6.35 + i*2.54 - 0.32, pin_z - 0.32]) cube([1.8, 0.64, 0.64]);
    // listwa goldpin + wtyczka dupont 1x6
    color([0.12, 0.12, 0.12]) translate([s_back - 2.5, yc - plug_w/2, pin_z - plug_h/2]) cube([2.5, plug_w, plug_h]);
    color([0.07, 0.07, 0.07]) translate([plug_end, yc - plug_w/2, pin_z - plug_h/2]) cube([hl, plug_w, plug_h]);
    // łebki wkrętów
    if (screw_s)
        for (y = s_hys) color([0.6, 0.6, 0.65]) translate([s_face, y, s_hz]) rotate([0, 90, 0])
            cylinder(d = 3.8, h = 1.5);
}

wire_cols = [[0.55, 0.3, 0.2], [0.1, 0.1, 0.1], [0.95, 0.95, 0.95],
             [0.55, 0.55, 0.55], [0.75, 0.1, 0.4], [0.1, 0.35, 0.85]];

module wire(pts, d = 1.3) {
    for (k = [0:len(pts) - 2])
        hull() { translate(pts[k]) sphere(d = d, $fn = 10); translate(pts[k + 1]) sphere(d = d, $fn = 10); }
}

// kable: z wtyczki czujnika przez przepust w przegrodzie, górą do pinów NodeMCU
module wires_ghost() {
    zw = div_top - wire_d/2;
    for (i = [0:5]) {
        t  = dup[i];
        tx = pcb_x0 + t[0];
        ty = pcb_y0 + t[1];
        yn = yc - 3.5 + i*1.4;
        yp = yc - 6.35 + i*2.54;
        start = screw_s
            ? [[plug_end + 0.5, yp, pin_z], [plug_end - 4, yc - 5 + i*2, pin_z]]       // prosto
            : [[plug_end + 0.5, yp, pin_z], [plug_end - 2.5, yc - 5 + i*2, pin_z + 1.5],
               [x_s0 + 1.2, yn, pin_z + 6]];                                         // w górę
        color(wire_cols[i]) wire(concat(start, [
            [x_s0 + 1.2, yn, zw],
            [x_d1 - 2, yn, zw],
            [tx + (tx < x_d1 - 8 ? 3 : 1.5), ty + (ty > yc ? -1.5 : 1.5), dup_top + 1.2],
            [tx, ty, dup_top + 0.5],
            [tx, ty, dup_top - 0.5]]));
    }
}

module models() { nodemcu_ghost(); bme_ghost(); wires_ghost(); }

// ---------------------------------------------------------------------
//  Wybór części / podgląd
// ---------------------------------------------------------------------
module enclosure(lift = 0) {
    color([0.93, 0.93, 0.9]) base();
    color([0.62, 0.78, 0.93]) translate([0, 0, lift]) lid();
}
module scene(lift = 0, cut = false) {
    if (cut) difference() {     // przekrój: odcięta przednia połowa obudowy
        enclosure(lift);
        translate([-1, -1, -1]) cube([L + 2, yc + 1, H + 60]);
    }
    else enclosure(lift);
    // kolorowe płytki i kable tylko w podglądzie F5 ($preview); F6 i STL zawierają samą obudowę
    if (show_pcb && $preview) models();
}

// widok na ścianie: obudowa wysunięta o "slide" nad uchwyt (wsuwanie od góry)
module wall_view(slide = 25) {
    rotate([90, 0, 0]) {
        color([0.98, 0.62, 0.2]) mount();
        in_mount(slide) enclosure();
        %translate([m_xo - 30, m_y0 - 30, -mnt_gap - mnt_plate - 2]) cube([L - 2*m_xo + 60, m_y1 - m_y0 + 80, 2]);
    }
}

// kolory części (widać je w podglądzie; do STL kolor nie trafia)
c_base  = [0.93, 0.93, 0.9];
c_lid   = [0.62, 0.78, 0.93];
c_mount = [0.98, 0.62, 0.2];

if (part == "print")         { color(c_base) base(); color(c_lid) translate([0, -W - 6, 0]) lid_print(); }
else if (part == "print_all") {
    translate([-m_xo + 1, 0, 0]) { color(c_base) base(); color(c_lid) translate([0, -W - 6, 0]) lid_print(); }
    color(c_mount) translate([0, W + 8, 0]) mount_print();
}
else if (part == "base")     color(c_base) base();
else if (part == "lid")      color(c_lid) lid_print();
else if (part == "mount")    color(c_mount) mount_print();
else if (part == "mesh_test") color(c_lid) mesh_test();
else if (part == "wall")     wall_view();
else if (part == "assembly") scene();
else if (part == "exploded") scene(32);
else if (part == "section")  scene(0, true);
