gratak/default/obudowa-nodemcu-bme280/img/print.png

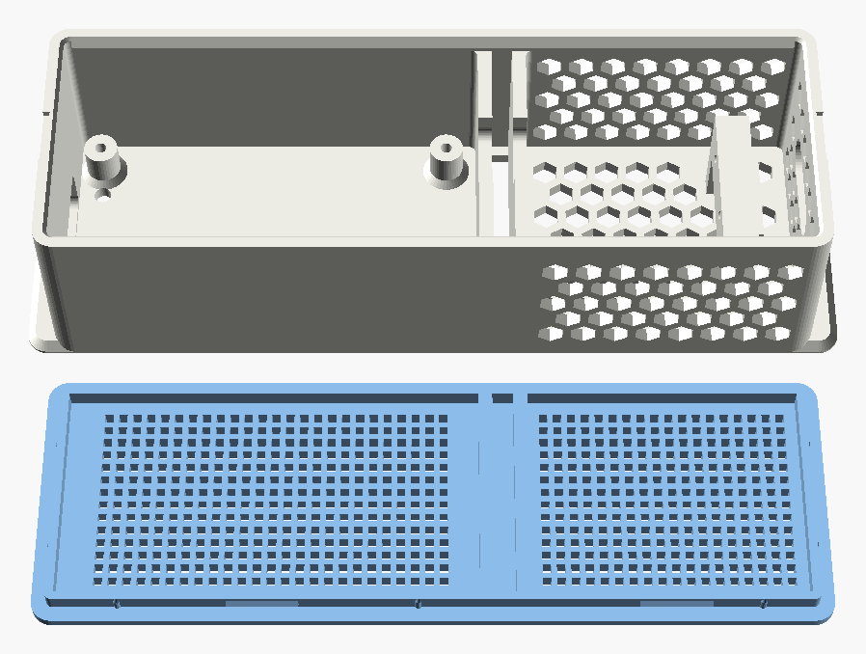
obudowa-nodemcu-bme280/img/print.png
