gratak/default/obudowa-nodemcu-bme280/img/uchwyt_print.png

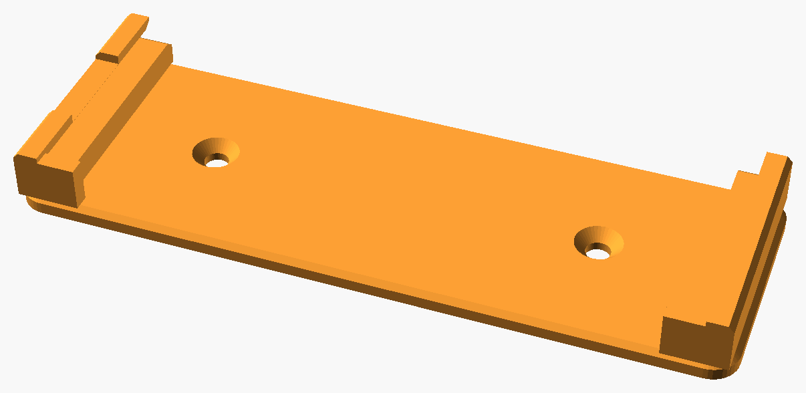
obudowa-nodemcu-bme280/img/uchwyt_print.png
