gratak/default/(commit log)

2026-11-09 Add parametric OpenSCAD enclosure for NodeMCU V3 + BME280
    Two-chamber case: slotted electronics bay with USB-C cutout, honeycomb
    openwork sensor bay, and a double solid divider with a vented air gap
    to keep ESP8266 heat away from the sensor. Includes print-ready STLs
    (base and lid, no supports needed), renders and a Polish README.
    Claude-Session: https://claude.ai/code/session_01DZNPfty8MZAy7iD4Y2LLgW
    [obudowa.scad, obudowa_podstawa.stl, obudowa_pokrywa.stl]
2026-11-09 Screw-mount the BME280 sensor on two posts instead of a press-fit cradle
    The sensor board now lies flat under the openwork lid, chip up, held by
    two self-tapping screws driven from above into 18.5 mm posts next to the
    end wall; the dupont plug hangs below it. The old plug cradle with lid
    hold-down remains available as sensor_mount = "cradle".
    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
    [obudowa.scad, obudowa_podstawa.stl, obudowa_pokrywa.stl]
2026-11-09 Vertical L-shaped sensor mount, print-ready default view, cable route
    - The BME280 board stands vertically again, forming an L with its
    dupont plug, and is screwed (2x M2.5x6, 10 mm hole spacing) to a
    portal frame behind it; the screwdriver goes through a window in the
    openwork end wall. The plug rests on a pedestal between the frame legs.
    - Openwork cells are now excluded by exact distance to the window, so
    the end wall keeps its honeycomb above and below it.
    - The file now opens on the two printable parts (part = "print"); board
    and cable models are background-only (%) and never end up in STL.
    - README and renders describe the sensor cable route through the divider.
    Co-Authored-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
    [obudowa.scad, obudowa_podstawa.stl, obudowa_pokrywa.stl]
2026-11-09 Longer sensor bay, top-loading sensor with straight cable run
    - Sensor chamber 30 -> 40 mm so the ~30 mm sensor module (pins, plug,
    bent wires) fits with ~6 mm to spare; 2 mm more headroom above the
    NodeMCU wiring. Outside size is now 111 x 38 x 30.6 mm.
    - The sensor still stands vertically in an L with its plug, but with the
    pins and plug on top at the height of the divider pass-through: the
    module drops in from above in front of a low frame, rests on a ledge
    and is screwed through the end-wall window; the cables run straight
    through the pass-through.
    - Checked: no collisions, vertical insertion path is clear, a 30 mm
    module fits.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
    [obudowa.scad, obudowa_podstawa.stl, obudowa_pokrywa.stl]
2026-11-09 Explain sensor screwing; widen end-wall window to 6 mm
    Adds an illustration of driving the sensor screws through the end-wall
    window into the holder frame (3D view plus top section) and step-by-step
    instructions in the README. The window is now 6 mm tall so larger screw
    heads pass; the honeycomb around it is unchanged.
    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
    [obudowa.scad, obudowa_podstawa.stl, obudowa_pokrywa.stl]
2026-11-09 Add slide-in wall mount
    - New printable wall holder (part = "mount"): back plate with two
    dovetail rails and bottom stops; the enclosure hangs horizontally,
    lid facing the room, and slides in from the top. A 5 mm air gap keeps
    the floor vents working and the sensor away from the wall. The rail on
    the USB-C side has a cut-out for the plug; usb_side picks left/right.
    Two countersunk wall screws hide behind the enclosure.
    - The base gets 45-degree flanges at both ends of its floor
    (wall_mount = false removes them). Prints flat without supports.
    - Checked: box rests on the stops, slides freely, is held against
    pulling off the wall, USB-C plug clears the holder on both sides.
    Co-Au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
    [obudowa.scad, obudowa_podstawa.stl, obudowa_pokrywa.stl, obudowa_uchwyt_scienny.stl]
2026-11-09 Show colored board and cable models in F5 preview again
    Board, sensor and cable models are drawn in color when $preview is true
    (F5) and skipped in F6 renders and STL export, instead of the grey
    background modifier. Printable parts are colored in every view too;
    colors never reach the STL.
    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
    [obudowa.scad]
2026-11-09 Add rotating exploded-view GIF of the enclosure
    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
2026-11-09 Add GIF of the enclosure sliding into the wall mount
    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
2026-11-09 Switch board and sensor screw holes to M2 self-tapping screws
    Pilot holes in the NodeMCU standoffs and the sensor holder frame are now
    1.7 mm for M2 self-tapping screws (M2.5 and M3 values stay in the
    comments). README, renders and illustrations updated; README recommends
    M2 washers or flange-head screws because the board holes are ~3 mm.
    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
    [obudowa.scad, obudowa_podstawa.stl]
2026-11-10 Remove side vents from the electronics bay, tighten the lid
    - Long walls of the electronics chamber are now solid
    (el_side_slots = true restores the slots); lid and floor vents stay.
    - Lid fit: clearance 0.2 -> 0.15 mm, snap ridges 0.5 -> 0.6 mm, plus
    ten vertical crush ribs (crush = 0.3) on the lid lip that take up
    printer tolerance. Checked: without ribs the lid does not intersect
    the base; only the ribs press in.
    - Renders, illustrations, GIFs, STLs and README updated.
    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
    [obudowa.scad, obudowa_podstawa.stl, obudowa_pokrywa.stl, obudowa_uchwyt_scienny.stl]
2026-11-10 Remove floor vents under the NodeMCU
    The electronics chamber floor is now solid except for the RST/FLASH
    access holes (floor_slots = true restores the vents). Renders, GIFs,
    STL and README updated.
    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
    [obudowa.scad, obudowa_podstawa.stl]
2026-11-10 Fine mesh instead of slots in the lid above the NodeMCU
    - Lid vents over the electronics are now a grid of 1.2 mm square holes
    with 0.8 mm webs (two 0.4 mm nozzle lines), so water drops do not get
    through; lid_vent = "slots" restores the old slots, mesh_hole and
    mesh_web tune the grid.
    - New part = "mesh_test": a small coupon with 0.8 / 1.0 / 1.2 / 1.5 mm
    hole fields to check what the printer can do (stl/probnik_siatki.stl).
    - Renders, GIFs, lid STL and README updated.
    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
    [obudowa.scad, obudowa_pokrywa.stl, probnik_siatki.stl]
2026-11-10 Close the lid slot above the cable pass-through
    The lid opening over the air gap between the double divider walls sat
    right above the cable pass-through, so a drop could run along the wires
    into the electronics bay. It is now closed (gap_lid_open = true restores
    it); the gap stays open at the bottom and still insulates.
    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
    [obudowa.scad, obudowa_pokrywa.stl]
2026-11-11 Fine mesh in the lid above the sensor as well
    The whole lid now uses the 1.2 mm square mesh (lid_sensor_mesh = false
    restores the honeycomb above the sensor). Side walls, end wall and floor
    of the sensor chamber keep the honeycomb; hole_shape = "mesh" can switch
    them to the fine mesh too. Base unchanged.
    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
    [obudowa.scad, obudowa_pokrywa.stl]
2026-11-12 Lid mesh holes 1.2 -> 1.5 mm
    The 1.2 mm holes printed but tended to clog; 1.5 mm with the same
    0.8 mm webs. Only the lid changes.
    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
    [obudowa.scad, obudowa_pokrywa.stl]
2026-11-12 Lid mesh holes 1.5 -> 2 mm
    Larger holes so they do not close up when printed; same 0.8 mm webs.
    Only the lid changes.
    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
    [obudowa.scad, obudowa_pokrywa.stl]
